Dmytrocode/CS207_UofR/Components.jpg

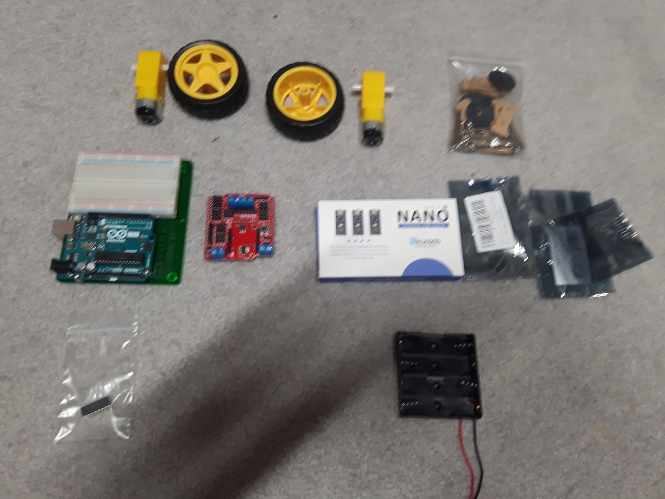
Components.jpg
