Dmytrocode/CS207_UofR/README.md

# Gesture Control Robotic Car | Final Project CS 207 

Repository dedicated to my CS 207 Class Electronics Project.

My Final Project for my Computer Science 207 class is a Remote Controlled Robotic Car that I built from scratch.

The project consists of a robotic car that is controllable by a remote control device. These two devices communicate between each other 
throughout bluetooth. The gesture control device detects the angle it is in, and sends the information over to the robotic car, which
translates thata data into real life movements and actions. 

Robotic Car

## Components and Materials:

x1 [Arduino UNO & Genuino UNO](https://www.amazon.ca/Arduino-Uno-R3-Microcontroller-ATmega328/dp/B07LD6DTFS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)

x1 [Arduino Nano V3.0](https://www.amazon.ca/Arduino-ELEGOO-ATmega328P-Compatible-Without/dp/B071NMD14Y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)

x2 [HC-05 Bluetooth Module](https://www.amazon.ca/J-DEAL%C2%AE-Wireless-Bluetooth-Transceiver-Arduino/dp/B01M248TJU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)

x1 [MPU 6050 Module 3 Axis Gyroscope](https://www.amazon.ca/Aukru-Module-Gyroscope-Accelerometer-Arduino/dp/B019SX74TE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)

x2 [DC Motors and x2 Wheels](https://www.amazon.ca/Electric-Magnetic-Gearbox-Plastic-Yeeco/dp/B07DQGX369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)

x1 [Neuftech L298n](https://www.amazon.ca/Neuftech-H-Bridge-Stepper-Controller-Raspberry/dp/B01KBTNHS6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)

x1 [L293D Motor Driver](https://www.amazon.ca/Stepper-Driver-Controllers-Channel-Ltvystore/dp/B07DNDWG9V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)
**Motor Driver in case the Arduino Shield does not work

x2 [9V Batteries or similar Power Supply](https://www.amazon.ca/s?k=9v+battery&ref=nb_sb_noss_2)

--------SOLDERING TOOLS AND EQUIPMENT MAY BE NEEDED-------

## Software Requirements
A preferable updated version of the Arduino IDE is recommended to use the programs.

### Libraries:
Please refer to the [Libraries](https://github.com/Dmytrocode/CS207_UofR/tree/master/libraries) Folder for information about the installation and use of libraries needed for this project.

## Build

### 1. Construct the Frame for the Robotic Car with two wheels, two DC motors, and a power supply


### 2. Place the top frame base and place the arduino with the motor shield or the circuit on top.

#### Follow the next sketch for the Arduino Robotic Car sketch / circuit: 


### 3. Construct the frame for the Gesture Control Device and follow the sketch




### 4. Upload the code in Order to the Bluetooth HC-05 devices, as well as the Arduino itself, and the Nano V3.
#### Click [THIS](https://github.com/Dmytrocode/CS207_UofR/tree/master/Code) link and follow the instructions in the Readme.md

### 5. Power on the two Robotic Car and the Remote control device --> Connect the Bluetooth devices, and the It's Ready to Play!

## REFERENCES

#### [Source for the Sketch Images](https://www.hackster.io/shubhamsuresh/how-to-make-a-gesture-control-robot-at-home-a3f4a4)
