Dmytrocode/CS207_UofR/(commit log)

2019-11-30 Add files via upload
    Materials and components gathered. Now it's time to start assembling the robot.
2019-11-30 Add files via upload
    All parts and components gathered. Now it's time to start assembling the robot.
2019-12-07 Add Robotic Car Arduino Program
    Arduino Program that gives instructions to the robotic car, such as the definition of directions and how to move depending on data obtained from the Gesture Remote Unit
